tymancjo/Dz3/img/IMG_4066 2.JPG

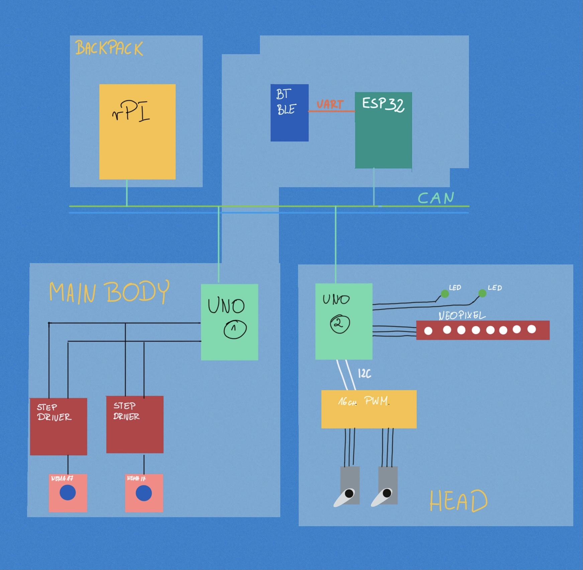
img/IMG_4066 2.JPG
