tymancjo/Dz3/img/IMG_5586.jpeg

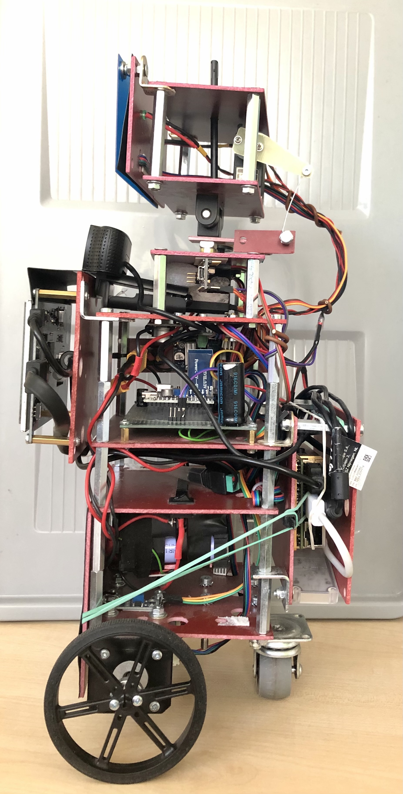
img/IMG_5586.jpeg
