tymancjo/Dz3/img/IMG_5587.jpeg

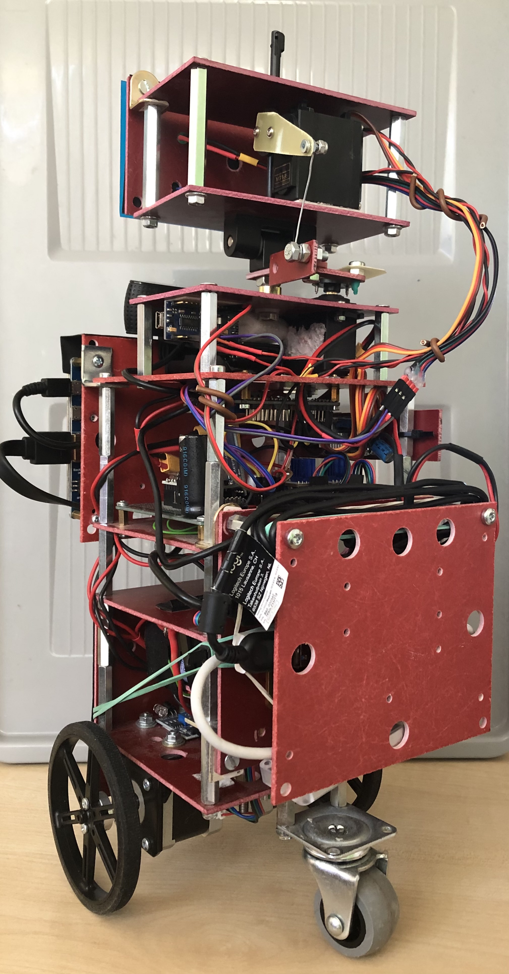
img/IMG_5587.jpeg
