tymancjo/Dz3/img/IMG_5588.jpeg

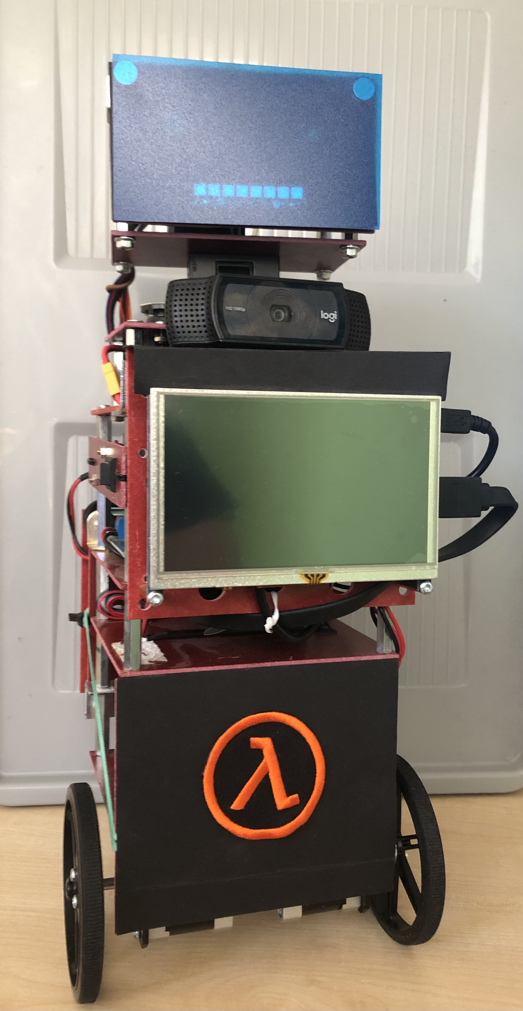
img/IMG_5588.jpeg
