tymancjo/Dz3/img/IMG_5589.jpeg

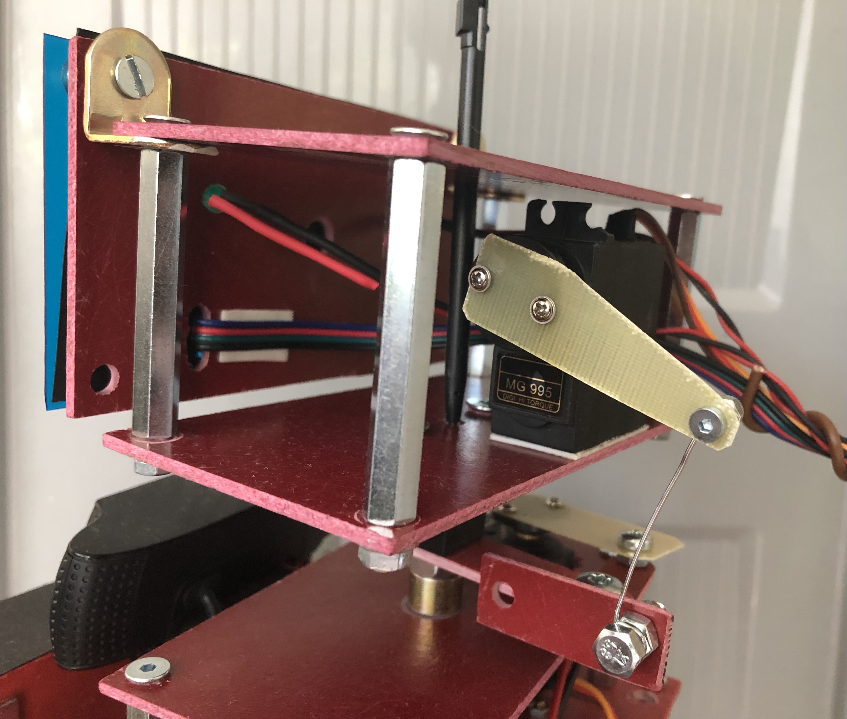
img/IMG_5589.jpeg
