tymancjo/Dz3/img/IMG_5590.jpeg

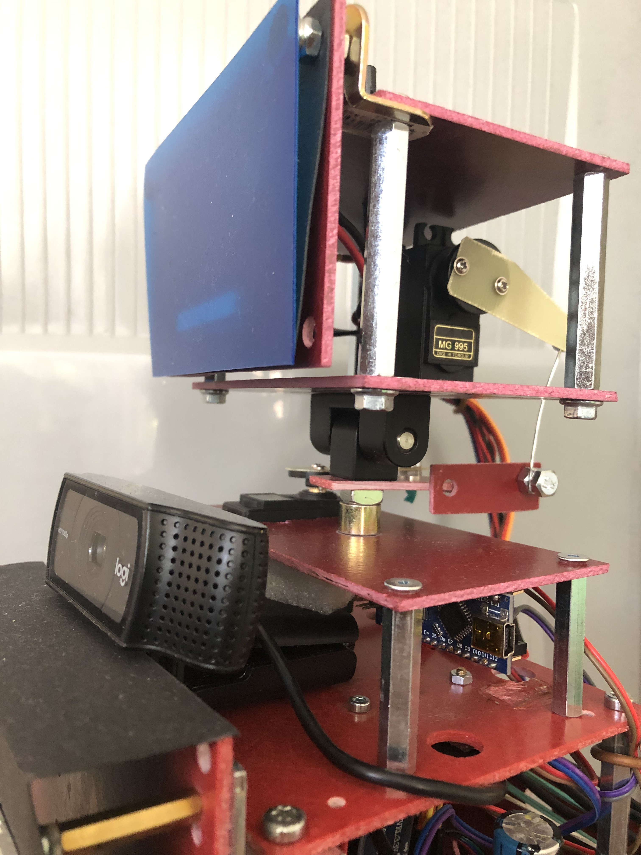
img/IMG_5590.jpeg
