tymancjo/Dz3/img/IMG_5591.jpeg

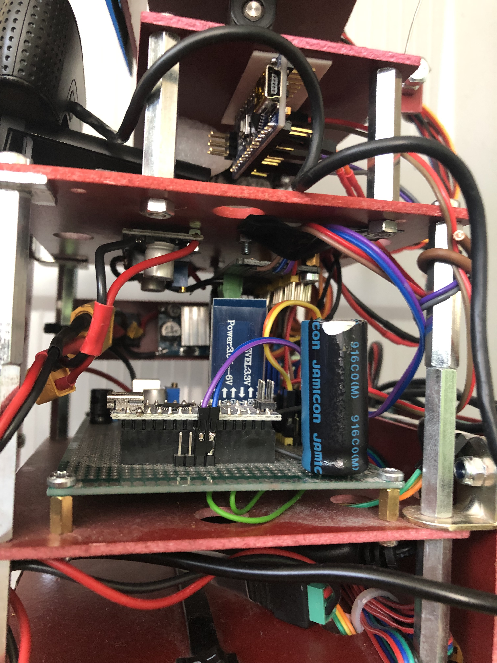
img/IMG_5591.jpeg
