tymancjo/Dz3/Python/ML_object_follower.py

# This script is based on:
######## Webcam Object Detection Using Tensorflow-trained Classifier #########
# 
# Author: Evan Juras
# Date: 10/27/19
# Description: 
# This program uses a TensorFlow Lite model to perform object detection on a live webcam
# feed. It draws boxes and scores around the objects of interest in each frame from the
# webcam. To improve FPS, the webcam object runs in a separate thread from the main program.
# This script will work with either a Picamera or regular USB webcam.
#
# This code is based off the TensorFlow Lite image classification example at:
# https://github.com/tensorflow/tensorflow/blob/master/tensorflow/lite/examples/python/label_image.py
#
# I added my own method of drawing boxes and labels using OpenCV.

# Import packages
import os
import argparse
import cv2
import numpy as np
import sys
import time
from threading import Thread
import importlib.util
import random
import math

import asyncio
from bleak import BleakClient, BleakScanner 
from bleak.exc import BleakError


class myObj:
    is_connected: bool = False

the_device = ""
the_service = ""

client = myObj()

##### bleak stuff for george
# Handling the BLE connetivity
async def BTsearch():
    """
    This function search for the BT devices 
    and setup the global bavariable if a robot is found
    The robot is identified by the name "BT05"
    """
    global the_device
    devices = await BleakScanner.discover()
    for i,d in enumerate(devices):
        print(f"[{i}]\t{d.name}\t{d.address}")
        if "BT05" in d.name:
            print(f"Potenitial robot found @ {d.address}")
            the_device = d.address
            
async def print_services(ble_address: str):
    """
    This finction checks for the BLE device internal
    services and identify the propper one for the uart via BT
    """
    global the_service
    device = await BleakScanner.find_device_by_address(ble_address, timeout=20.0)
    
    if not device:
        raise BleakError(f"A device with address {ble_address} could not be found.")

    async with BleakClient(device) as client:
        svcs = await client.get_services()
        print("Services:")
        for service in svcs:
            print(service)
            if "Vendor specific" in str(service):
                print(service.characteristics)
                for inside in service.characteristics:
                    print(f"Sub info properties: {inside.properties}")
                    print(f"Sub info uuid: {inside.uuid}")
                    the_service = inside.uuid

async def BTconnect():
    """
    Function to estabilish BLE connetion to the device
    """

    global client

    client = BleakClient(the_device,timeout=10)
    await client.connect()
    print(f"Connection status: {client.is_connected}")

async def BTdisconnect():
    """
    Function to disconnect for the BLE device"""
    if client.is_connected:
        await client.disconnect()
        print("The robot have been disconnected...")
    else:
        print("No robot to be disconnected!")
            
async def BTwrite(the_command, redial=True):
        if client.is_connected:
            await client.write_gatt_char(the_service,bytearray(the_command, "utf-8"), response=not True)
        else:
            print("No devce connected.")
            if redial and the_service:
                loop.run_until_complete(BTconnect())

print("Scanning for BLE devices...")
loop = asyncio.get_event_loop()
loop.run_until_complete(BTsearch())

if the_device:
    # If we have the device we can follow to connect

    print(f"there is Mariola at {the_device}")
    trys = 0
    while trys < 5:
        try:
            loop.run_until_complete(print_services(the_device))
            break
        except:
            trys += 1
            print("Issue...")

    if the_service:
        print(f"Found Vendor sercvice at {the_service}")
        # as we found what we were looking for we try to connect
        time.sleep(2) #wait as it sometimes makes issues on rPI if too fast
        trys = 0
        while trys < 5:
            try:
                loop.run_until_complete(BTconnect())
                break
            except:
                trys += 1
                print("issue....")

        
        if client.is_connected:
            loop.run_until_complete(BTwrite('<1,0,5,500>'))
            time.sleep(0.5)
            loop.run_until_complete(BTwrite('<1,0,-5,500>'))


else:
    print("Can't find robot :(")


# Define VideoStream class to handle streaming of video from webcam in separate processing thread
# Source - Adrian Rosebrock, PyImageSearch: https://www.pyimagesearch.com/2015/12/28/increasing-raspberry-pi-fps-with-python-and-opencv/
class VideoStream:
    """Camera object that controls video streaming from the Picamera"""
    def __init__(self,resolution=(640,480),framerate=30):
        # Initialize the PiCamera and the camera image stream
        self.stream = cv2.VideoCapture(0)
        ret = self.stream.set(cv2.CAP_PROP_FOURCC, cv2.VideoWriter_fourcc(*'MJPG'))
        ret = self.stream.set(3,resolution[0])
        ret = self.stream.set(4,resolution[1])
            
        # Read first frame from the stream
        (self.grabbed, self.frame) = self.stream.read()

        # Variable to control when the camera is stopped
        self.stopped = False

    def start(self):
	# Start the thread that reads frames from the video stream
        Thread(target=self.update,args=()).start()
        return self

    def update(self):
        # Keep looping indefinitely until the thread is stopped
        while True:
            # If the camera is stopped, stop the thread
            if self.stopped:
                # Close camera resources
                self.stream.release()
                return

            # Otherwise, grab the next frame from the stream
            (self.grabbed, self.frame) = self.stream.read()

    def read(self):
	# Return the most recent frame
        return self.frame

    def stop(self):
	# Indicate that the camera and thread should be stopped
        self.stopped = True

# Define and parse input arguments
parser = argparse.ArgumentParser()
parser.add_argument('--modeldir', help='Folder the .tflite file is located in',
                    required=False, default='Sample_TFLite_model')
parser.add_argument('--graph', help='Name of the .tflite file, if different than detect.tflite',
                    default='detect.tflite')
parser.add_argument('--labels', help='Name of the labelmap file, if different than labelmap.txt',
                    default='labelmap.txt')
parser.add_argument('--threshold', help='Minimum confidence threshold for displaying detected objects',
                    default=0.5)
parser.add_argument('--resolution', help='Desired webcam resolution in WxH. If the webcam does not support the resolution entered, errors may occur.',
                    default='1280x720')
parser.add_argument('--edgetpu', help='Use Coral Edge TPU Accelerator to speed up detection',
                    action='store_true')

args = parser.parse_args()

MODEL_NAME = args.modeldir
GRAPH_NAME = args.graph
LABELMAP_NAME = args.labels
min_conf_threshold = float(args.threshold)
resW, resH = args.resolution.split('x')
resW = int(int(resW) / 2)
resH = int(int(resH) / 2)
imW, imH = int(resW), int(resH)
use_TPU = not args.edgetpu


# Import TensorFlow libraries
# If tflite_runtime is installed, import interpreter from tflite_runtime, else import from regular tensorflow
# If using Coral Edge TPU, import the load_delegate library
pkg = importlib.util.find_spec('tflite_runtime')
if pkg:
    from tflite_runtime.interpreter import Interpreter
    if use_TPU:
        from tflite_runtime.interpreter import load_delegate
else:
    from tensorflow.lite.python.interpreter import Interpreter
    if use_TPU:
        from tensorflow.lite.python.interpreter import load_delegate

# If using Edge TPU, assign filename for Edge TPU model
if use_TPU:
    # If user has specified the name of the .tflite file, use that name, otherwise use default 'edgetpu.tflite'
    if (GRAPH_NAME == 'detect.tflite'):
        GRAPH_NAME = 'edgetpu.tflite'       

# Get path to current working directory
CWD_PATH = os.getcwd()

# Path to .tflite file, which contains the model that is used for object detection
PATH_TO_CKPT = os.path.join(CWD_PATH,MODEL_NAME,GRAPH_NAME)

# Path to label map file
PATH_TO_LABELS = os.path.join(CWD_PATH,MODEL_NAME,LABELMAP_NAME)

# Load the label map
with open(PATH_TO_LABELS, 'r') as f:
    labels = [line.strip() for line in f.readlines()]

# Have to do a weird fix for label map if using the COCO "starter model" from
# https://www.tensorflow.org/lite/models/object_detection/overview
# First label is '???', which has to be removed.
if labels[0] == '???':
    del(labels[0])

# Load the Tensorflow Lite model.
# If using Edge TPU, use special load_delegate argument
if use_TPU:
    interpreter = Interpreter(model_path=PATH_TO_CKPT,
                              experimental_delegates=[load_delegate('libedgetpu.so.1.0')])
    print(PATH_TO_CKPT)
else:
    interpreter = Interpreter(model_path=PATH_TO_CKPT)

interpreter.allocate_tensors()

# Get model details
input_details = interpreter.get_input_details()
output_details = interpreter.get_output_details()
height = input_details[0]['shape'][1]
width = input_details[0]['shape'][2]

floating_model = (input_details[0]['dtype'] == np.float32)

input_mean = 127.5
input_std = 127.5

# Initialize frame rate calculation
frame_rate_calc = 1
freq = cv2.getTickFrequency()

# Initialize video stream
videostream = VideoStream(resolution=(imW,imH),framerate=30).start()
time.sleep(1)
cv2.namedWindow('the_screen', cv2.WINDOW_FREERATIO)
# cv2.setWindowProperty('the_screen', cv2.WND_PROP_FULLSCREEN, cv2.WINDOW_FULLSCREEN)

# some initial values here
the_X = resW/2
the_Y = 3*resH/4
aver_x = the_X
aver_y = the_Y
delta = 0
prev_delta = 0
sum_delta = 0
deltaY = 0
prev_delta_y = 0

area_delta = 0
area_prev_delta = 0
area_sum_delta = 0

prev_turn = aver_x
prev_turn_y = aver_y
prev_area = 0

no_object_loops = 0
move_time = time.time()

face_mode = False
move_mode = False
turn_mode = False
search_mode = False
use_eyes = not False
face_timer = time.time()
eyes_timer = 0
prev_eyes_angle = 0 
prev_eyes_angle_y = 0 

eye_x = 0
happy = 0

# the PID part
# PID for the rotation
# P = 1
# I = 0.000
# D = 0.015
P = 0.15
I = 0.0010
D = 0.03

# PID for the move
# mP = 1
# mI = 0.001
# mD = 0.01
mP = 0.7
mI = 0.0001
mD = 0.01

target_class = 0
target_area = 0.4
reverse = 0
pid_out = 0
area_pid_out = 0

def create_blank(width, height, color=(0, 0, 0)):
    """Create new image(numpy array) filled with certain color in BGR"""
    image = np.zeros((height, width, 3), np.uint8)
    # Fill image with color
    image[:] = color
    return image


while True:

    # Start timer (for calculating frame rate)
    t1 = cv2.getTickCount()

    # Grab frame from video stream
    frame1 = videostream.read()

    # Acquire frame and resize to expected shape [1xHxWx3]
    frame = frame1.copy()
    frame_rgb = cv2.cvtColor(frame, cv2.COLOR_BGR2RGB)
    frame_resized = cv2.resize(frame_rgb, (width, height))
    input_data = np.expand_dims(frame_resized, axis=0)

    # Normalize pixel values if using a floating model (i.e. if model is non-quantized)
    if floating_model:
        input_data = (np.float32(input_data) - input_mean) / input_std

    # Perform the actual detection by running the model with the image as input
    interpreter.set_tensor(input_details[0]['index'],input_data)
    interpreter.invoke()

    # Retrieve detection results
    boxes = interpreter.get_tensor(output_details[0]['index'])[0] # Bounding box coordinates of detected objects
    classes = interpreter.get_tensor(output_details[1]['index'])[0] # Class index of detected objects
    scores = interpreter.get_tensor(output_details[2]['index'])[0] # Confidence of detected objects
    #num = interpreter.get_tensor(output_details[3]['index'])[0]  # Total number of detected objects (inaccurate and not needed)

    # Loop over all detections and draw detection box if confidence is above minimum threshold
    persons = 0
    centers = []
    centersY = []
    areas = []

    for i in range(len(scores)):
        if int(classes[i]) == target_class:
        # if True:
            if ((scores[i] > min_conf_threshold) and (scores[i] <= 1.0)):
                persons += 1

                # Get bounding box coordinates and draw box
                # Interpreter can return coordinates that are outside of image dimensions, need to force them to be within image using max() and min()
                ymin = int(max(1,(boxes[i][0] * imH)))
                xmin = int(max(1,(boxes[i][1] * imW)))
                ymax = int(min(imH,(boxes[i][2] * imH)))
                xmax = int(min(imW,(boxes[i][3] * imW)))
                
                cv2.rectangle(frame, (xmin,ymin), (xmax,ymax), (10, 255, 0), 2)
                
                centers.append(xmin+(xmax-xmin)/2)
                centersY.append(ymin+(ymax-ymin)/2)
                areas.append((ymax-ymin)*(xmax - xmin)/(imW*imH))

                if not face_mode:
                    # Draw label
                    object_name = labels[int(classes[i])] # Look up object name from "labels" array using class index
                
                    label = '%s: %s: %d%%: %d%%' % (object_name, classes[i], int(scores[i]*100), 100*areas[-1]) # Example: 'person: 72%'
                    labelSize, baseLine = cv2.getTextSize(label, cv2.FONT_HERSHEY_SIMPLEX, 0.7, 2) # Get font size
                    label_ymin = max(ymin, labelSize[1] + 10) # Make sure not to draw label too close to top of window
                    cv2.rectangle(frame, (xmin, label_ymin-labelSize[1]-10), (xmin+labelSize[0], label_ymin+baseLine-10), (255, 255, 255), cv2.FILLED) # Draw white box to put label text in
                    cv2.putText(frame, label, (xmin, label_ymin-7), cv2.FONT_HERSHEY_SIMPLEX, 0.7, (0, 0, 0), 2) # Draw label text

    if len(centers):
        aver_x = sum(centers) / len(centers)
        aver_y = sum(centersY) / len(centersY)
        dist_area = max(areas) 
        # aver_x = centers[0]
        # dist_area = areas[0]
        happy = 0.6 * happy + 0.4 * persons
        search_mode = False
    else:
        dist_area = 0
        if no_object_loops > 200:
            search_mode = True

            no_object_loops = 0
            happy = -1
            reverse *= -1
        else:
            no_object_loops += 1
            happy = 0.8 * happy - 0.2
            if happy < -1:
                happy = -1

    now = time.time()

    if not search_mode:
        aver_x = 0.7 * prev_turn + 0.3 * aver_x
        aver_y = 0.7 * prev_turn_y + 0.3 * aver_y
        prev_turn = aver_x
        prev_turn_y = aver_y

        dist_area = 0.9 * prev_area + 0.1 * dist_area
        prev_area = dist_area

        # Turning analysis
        prev_delta_y = deltaY
        deltaY = ( the_Y - aver_y ) / resH
        # deth zone by delta
        if abs(deltaY) < 0.01: deltaY = 0

        # Turning analysis
        prev_delta = delta
        delta = ( the_X - aver_x ) / resW

        # Moving analysis
        area_prev_delta = area_delta
        area_delta = target_area - dist_area
        if abs(area_delta) < 0.05: area_delta = 0
        area_sum_delta += area_delta
        area_diff_delta = area_prev_delta - area_delta

        # mechanical eyes move stuff
        eyes_angle = (40 * (1 + delta * 3 ))
        eyes_angle = int(0.5 * eyes_angle + 0.5 * prev_eyes_angle)

        # eyes_angle_y = 45
        eyes_angle_y = (55 * (1 + deltaY * 4 ))
        eyes_angle_y = int(0.5 * eyes_angle_y + 0.5 * prev_eyes_angle_y)

        eyes_angle = max(0,min(85,eyes_angle))
        eyes_angle_y = max(0,min(85,eyes_angle_y))
        prev_eyes_angle = eyes_angle



        # deth zone by delta
        if turn_mode:
            if abs(delta) < 0.25:
                delta = 0

            sum_delta += delta
            diff_delta = prev_delta - delta

            pid_out = P * delta + I * sum_delta + D * diff_delta
            area_pid_out = mP * area_delta + mI * area_sum_delta + mD * area_diff_delta

            pid_out = round(pid_out, 3)
            area_pid_out = round(area_pid_out, 3)

            # addingo some hysteresis behaviour
            # if abs(pid_out) < 0.05:
            #     pid_out = 0

            turn_amount = int(pid_out * 180)
            turn_speed = (abs(pid_out) * 10000)

            # if abs(area_pid_out) < 0.08:
            #     area_pid_out = 0

            move_amount = 50 * area_pid_out
            move_amount *= int(move_mode)
            move_amount = int(move_amount)

            move_speed = (9000 * abs(area_pid_out))

            # more emphasis on turns than moves
            if turn_amount > 1:
                # move_amount = move_amount // 10
                move_amount = 0
                move_speed = 0


            # final_speed = int((move_speed + turn_speed) / 2)
            final_speed = min(1700,max(move_speed, turn_speed))

            # making the calls sended max 5 time per second
            if client.is_connected and now > move_time + 0.02:
                move_time = now
                # if we are connected to the robot we send commands.
                trys = 0
                while trys < 2:
                    try:
                        loop.run_until_complete(BTwrite(f'<1,{move_amount},{turn_amount},{final_speed}>'))
                        break
                    except:
                        trys += 1
    else:
        final_speed = 400
        move_amount = 0
        turn_amount = 60 

        if client.is_connected and now > move_time + 0.02:
            move_time = now
            # if we are connected to the robot we send commands.
            trys = 0
            while trys < 2:
                try:
                    loop.run_until_complete(BTwrite(f'<1,{move_amount},{turn_amount},{final_speed}>'))
                    break
                except:
                    trys += 1


    if client.is_connected and use_eyes and now > eyes_timer + 0.06:
        eyes_timer = now
        trys = 0
        while trys < 2:
            try:
                loop.run_until_complete(BTwrite(f'<41,0,{eyes_angle},0>'))
                loop.run_until_complete(BTwrite(f'<41,1,{eyes_angle_y},0>'))
                break
            except:
                trys += 1

    # The face look
    if face_mode:
        # frame = create_blank(resW, resH, (125,0,0))

        # the eyes:
        eye_x0 = 200
        eye_y0 = 170
        eye_dx = 400
        wx = 30
        wy = 30
        min_x = eye_x0 - 85
        max_x = eye_x0 + 85

        eye_x = min(max_x, int(0.8 * eye_x + 0.2 * (eye_x0 + delta * 400)))
        eye_x = max(eye_x, min_x)
        
        # mouth
        mth_y0 = 320
        mth_h = 40
        mth_n = 8

        face_color = (125,0,0)
        eyes_color = (255,255,255)
        mouth_color = (255,255,255)

        if move_mode: 
            face_color = (3,200,200)
            eyes_color = (2,2,2)
            mouth_color = (2,2,2)
            mth_h = 20
            mth_n = 20
            mth_y0 = 380
        
        if use_eyes:
            # face_color = (12,150,242) 
            face_color = (125,0,0)
            mouth_color = (255,255,255)
            mth_h = 65
            mth_n = 6
            mth_y0 = 200

        if time.time() > face_timer + random.randint(1,3):
            face_timer = time.time()
            wy = 5

        frame = create_blank(800, 480, face_color)
        
        if not use_eyes:
            if not move_mode:
                cv2.rectangle(frame,(eye_x - wx, eye_y0 - wy), (eye_x + wx, eye_y0 + wy), eyes_color, -1)
                cv2.rectangle(frame,(eye_x + eye_dx - wx, eye_y0 - wy), (eye_x + eye_dx + wx, eye_y0 + wy), mouth_color, -1)
            else:
                cv2.rectangle(frame, (0, eye_y0 - 50),(800, eye_y0+50),
                                (125,125,125), -1 )
                cv2.circle(frame, (eye_x0, eye_y0), 100, (255,255,255), -1)
                cv2.circle(frame, (eye_x0 + eye_dx, eye_y0), 100, (255,255,255), -1)
                cv2.ellipse(frame, (eye_x, eye_y0+5), (wx, wy),
                            0, 0, 360, eyes_color, -1)
                cv2.ellipse(frame, (eye_x + eye_dx, eye_y0+5), (wx, wy),
                            0, 0, 360, eyes_color, -1)

                cv2.circle(frame, (eye_x0, eye_y0), 105, (155,155,155), 20)
                cv2.circle(frame, (eye_x0 + eye_dx, eye_y0), 105, (155,155,155), 20)


        mth_x0 = int((800 - mth_n * (mth_h + 0))/2)
        t_y = mth_y0
        for i in range(mth_n):
            t_x = i * (mth_h + 0) + mth_x0

            dy = happy * mth_h * 0.2
            if i > mth_n // 2:
                dy *= -1
            if i == mth_n // 2:
                dy = 0

            t_y += dy 
            t_y = int( t_y )

            cv2.rectangle(frame,(t_x, t_y), (t_x + mth_h, t_y + mth_h), mouth_color, -1)

        cv2.putText(frame,'turn: {0:.4f}, move: {1:.4f}'.format(pid_out, area_pid_out),(30,50),cv2.FONT_HERSHEY_SIMPLEX,0.5,(0,0,0),2,cv2.LINE_AA)
        pass
    else:
        # Draw framerate in corner of frame
        # cv2.putText(frame,'FPS: {0:.2f}, persons: {1} {2}'.format(frame_rate_calc, persons, delta),(30,50),cv2.FONT_HERSHEY_SIMPLEX,0.5,(255,255,0),2,cv2.LINE_AA)
        cv2.putText(frame,'turn: {0:.4f}, move: {1:.4f}'.format(pid_out, area_pid_out),(30,30),cv2.FONT_HERSHEY_SIMPLEX,0.5,(0,0,0),2,cv2.LINE_AA)
        cv2.putText(frame,f'P: {P:.4f}, I: {I:.4f} D: {D:.4f}',(30,50),cv2.FONT_HERSHEY_SIMPLEX,0.5,(0,0,0),2,cv2.LINE_AA)
        # cv2.putText(frame,f'P: {mP:.4f}, I: {mI:.4f} D: {mD:.4f}',(30,90),cv2.FONT_HERSHEY_SIMPLEX,0.5,(0,0,0),2,cv2.LINE_AA)
        cv2.putText(frame,f'Area: {target_area*100:.2f}%  Eyes: {use_eyes} {eyes_angle}',(30,70),cv2.FONT_HERSHEY_SIMPLEX,0.5,(0,0,0),2,cv2.LINE_AA)

    # All the results have been drawn on the frame, so it's time to display it.
    cv2.imshow('the_screen', frame)

    # Calculate framerate
    t2 = cv2.getTickCount()
    time1 = (t2-t1)/freq
    frame_rate_calc= 1/time1

    # Press 'q' to quit
    key_pressed = cv2.waitKey(1)
    if key_pressed == ord('q'):
        loop.run_until_complete(BTwrite(f'<0,0,0,500>'))
        break

    elif key_pressed == ord('f'):
        face_mode = not face_mode

    elif key_pressed == ord('m'):
        move_mode = not move_mode

    elif key_pressed == ord('t'):
        turn_mode = not turn_mode
        
    elif key_pressed == ord('h'):
        use_eyes = not use_eyes

    elif key_pressed == ord('1'):
        P += 0.05
    elif key_pressed == ord('2'):
        P -= 0.05
    elif key_pressed == ord('3'):
        I += 0.0001
    elif key_pressed == ord('4'):
        I -= 0.0001
    elif key_pressed == ord('5'):
        D += 0.0005
    elif key_pressed == ord('6'):
        D -= 0.0005

    elif key_pressed == ord('a'):
        target_area += 0.05
    elif key_pressed == ord('z'):
        target_area -= 0.05

    elif key_pressed == ord('b'):
        if target_class == 0:
            target_class = 51
            target_area = 0.2
        else:
            target_class = 0
            target_area = 0.4
# Clean up
cv2.destroyAllWindows()
videostream.stop()
# and we disconnect
loop.run_until_complete(BTdisconnect())
print("Done...")

#end
