tymancjo/Dz3/(commit log)

2020-10-17 little calibrationof the turning precision (dist of wheels changed to 175mm) and zoomfeature in py
2020-10-19 initial manual control buttons added
2020-10-24 Experiment with openCV track
2020-10-24 modof py track to use object size
2020-10-24 adding PID control to Dz3 ball following moves
2020-10-26 Release version of the pypath control with arc turns.in ino size of wheels calib.
2020-10-31 some arduino part adjustement for new drivers, and fresh start with py ball follow
2020-11-01 mod in ball following when outof frame
2020-11-05 pypath - cleaning stuff, fixing draws of 360deg arcs
    [pypath.py]
2020-11-07 deep cealning in pypath. Addes snap, mouse wheelcontrol for sliders... and more
    [pypath.py]
2020-11-10 Added PWM driver servo control via command 41 to the Arduino code
2020-11-10 uploadfromrPI - adding folloe ball up down with servo
2020-11-11 Trying to fix ballsearch part of alg. for dzordz_visual_control.py
    [dzordz_visual_control.py]
2020-11-20 fixing the moving back instead front
    [dzordz_visual_control.py]
2020-11-21 Deep changes in Arduino code. Manual dontrol added to pypath
2021-08-23 adding the tensor flow solution
2021-08-24 updated PID for person follow
2021-08-26 Cleaning up PID's Making more stable movements
2021-08-27 Added bannana track
2021-09-04 Some PID changes and temporal filters adjust
